rishitpuligadda/CNN_Accelerator/synthesis/schematic/pe.png

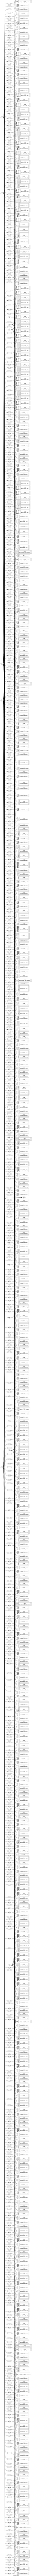
synthesis/schematic/pe.png
