rishitpuligadda/CNN_Accelerator/(commit log)

2026-10-21 Implemented processing element for the systolic array which has its own enable signal to ensure that it only works when needed and doesn't work when it is ideal
    [Processing_Element.v, tb_processing_element.v]
2026-10-21 reset assert is async while the deassert of the reset is synced with the clock
    [reset_sync.v]
2026-10-21 Tests the systolic array and also prints out which pes are active at a given time and to ensure that this particular pe should be active for this time, is decided by a k factor which lies in the tb a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
2026-10-22 systolic_array: stream results per column instead of full-tile output
    Replace the TILE_MAX*TILE_MAX*ACC_W output bus c with a per-column stream: c_col (TILE_MAX*ACC_W), c_row and c_valid. Because of the diagonal skew, each column has at most one PE done per cycle and finishes rows in order, so a one-hot AND-OR mux on pe_done selects the result with no extra storage. Allows back-to-back tiles with a single idle cycle between them, provided the second tile has K >= TILE_MAX-1.
    [systolic_array.v]
2026-10-23 Implemented a dma to store data from the dram to sram and implemeneted a skew buffer
2026-10-24 Implemented a dma to write into the sram
2026-10-26 Added a handshake for the external memory so that if the external memory is slow and doesn't provide data every 1 cycle then it wouldn't cause any issues and pass the data correctly
    [dma.v]
2026-10-27 no more stalls because of the enable logic and no half finished result because of the enable going low inbetween a cycle
    [Processing_Element.v, systolic_array.v]
2026-10-27 so now it doesnt have its own down counter but the top module manages both the weights counter and the activation counter so that there is no mismatch by mistake and the conv happens the way we want 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
    [wgt_feeder.v]
2026-10-27 responsible for giving the information related to the layer and I did a wrong commit before TvT
    [layer_config.v]
2026-10-28 Did synthesis of the processing element and there is a sub directory which has the schematic of that as well
2026-10-28 made a back pressure which has a fifo and credit counter which tracks the packets to send it to the simd which will do the post processing
2026-11-04 Add CNN model scripts and custom image flow
